shreyansh1298/Independent_Study/README.md

# Independent_Study
An embedded system to control temperature using Arduino, IR Bulb, and Peltier
