shreyansh1298/Independent_Study/SCH_Schematic1_2025-07-17.pdf

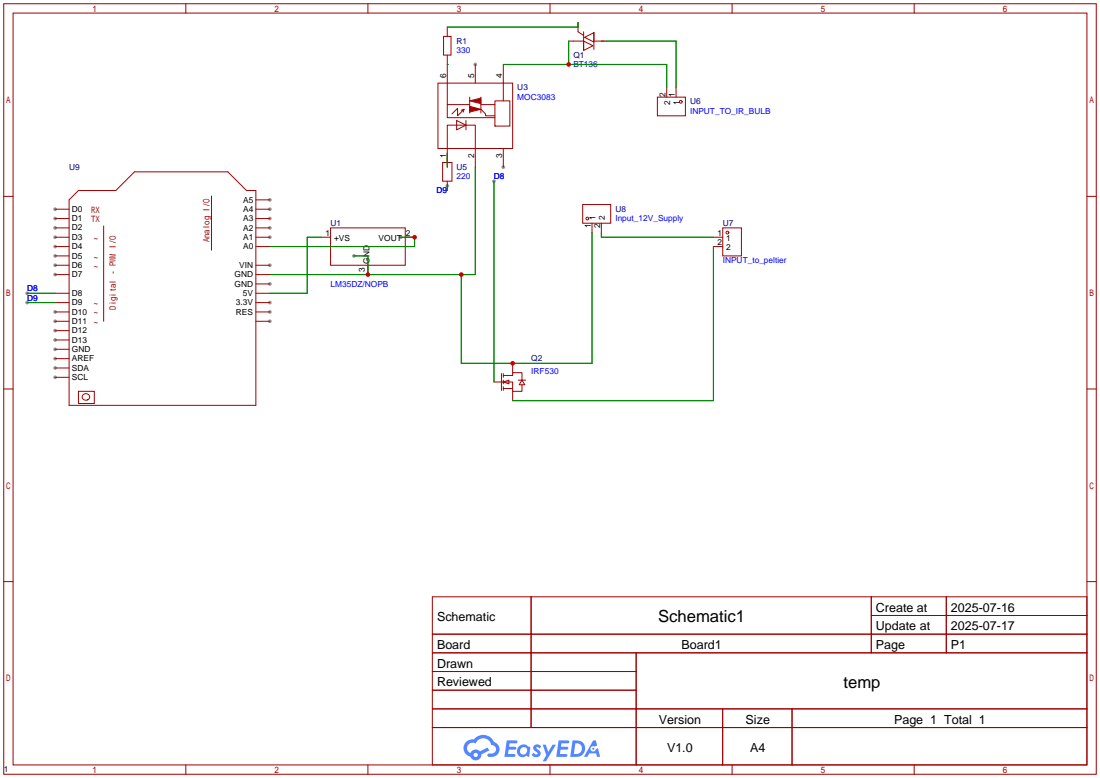
[picture p10: page 1]

Schematic | Schematic1 | Create at | 2025-07-16

Update at | 2025-07-17

Board | Board1 | Page | P1
Drawn | | temp
Reviewed

Version | Size | Page 1 Total 1
V1.0 | A4
